Kevin75311/FingerLight/app/shots/shot_library.png

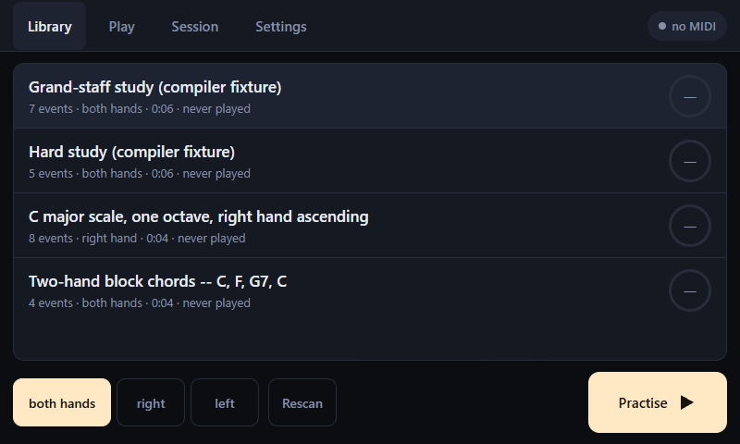
app/shots/shot_library.png
