Kevin75311/FingerLight/app/shots/shot_play.png

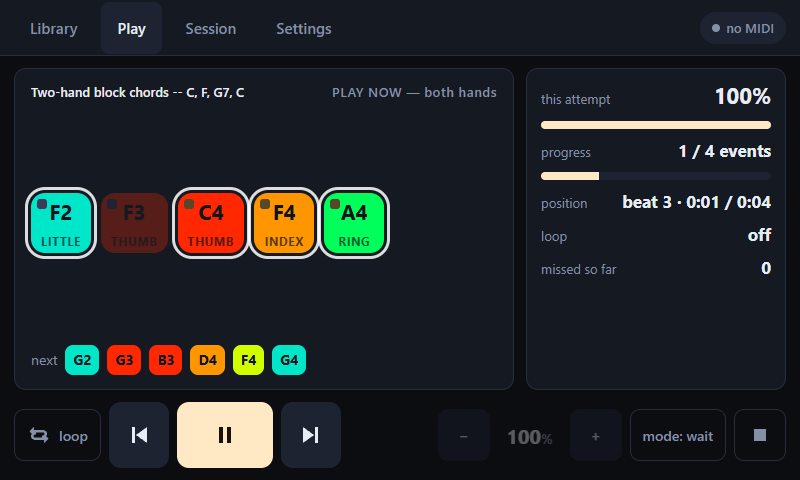
app/shots/shot_play.png
