Kevin75311/FingerLight/app/shots/shot_play_1280x720.png

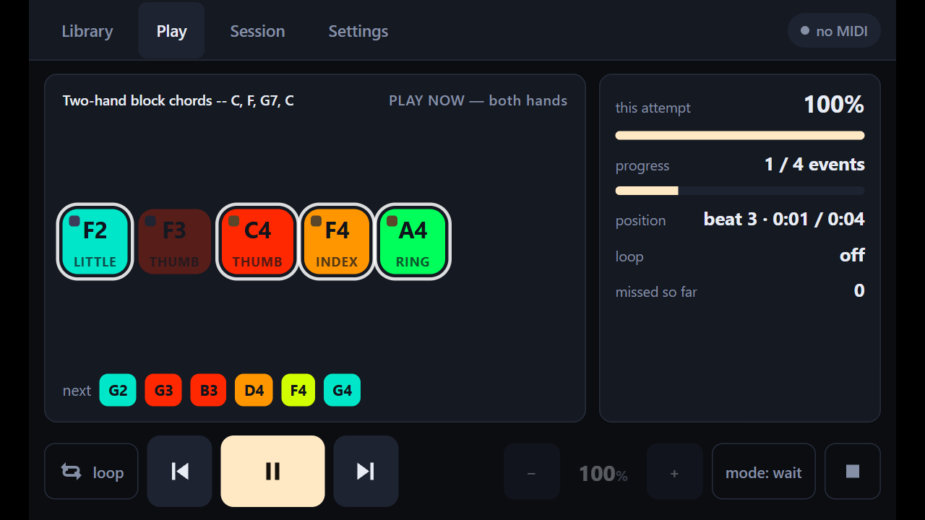
app/shots/shot_play_1280x720.png
