Kevin75311/FingerLight/app/shots/shot_play_along.png

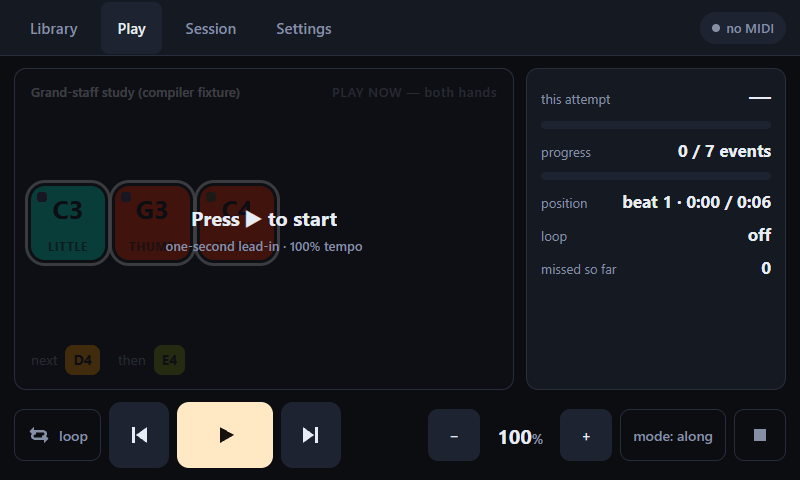
app/shots/shot_play_along.png
