Kevin75311/FingerLight/app/shots/shot_preview.png

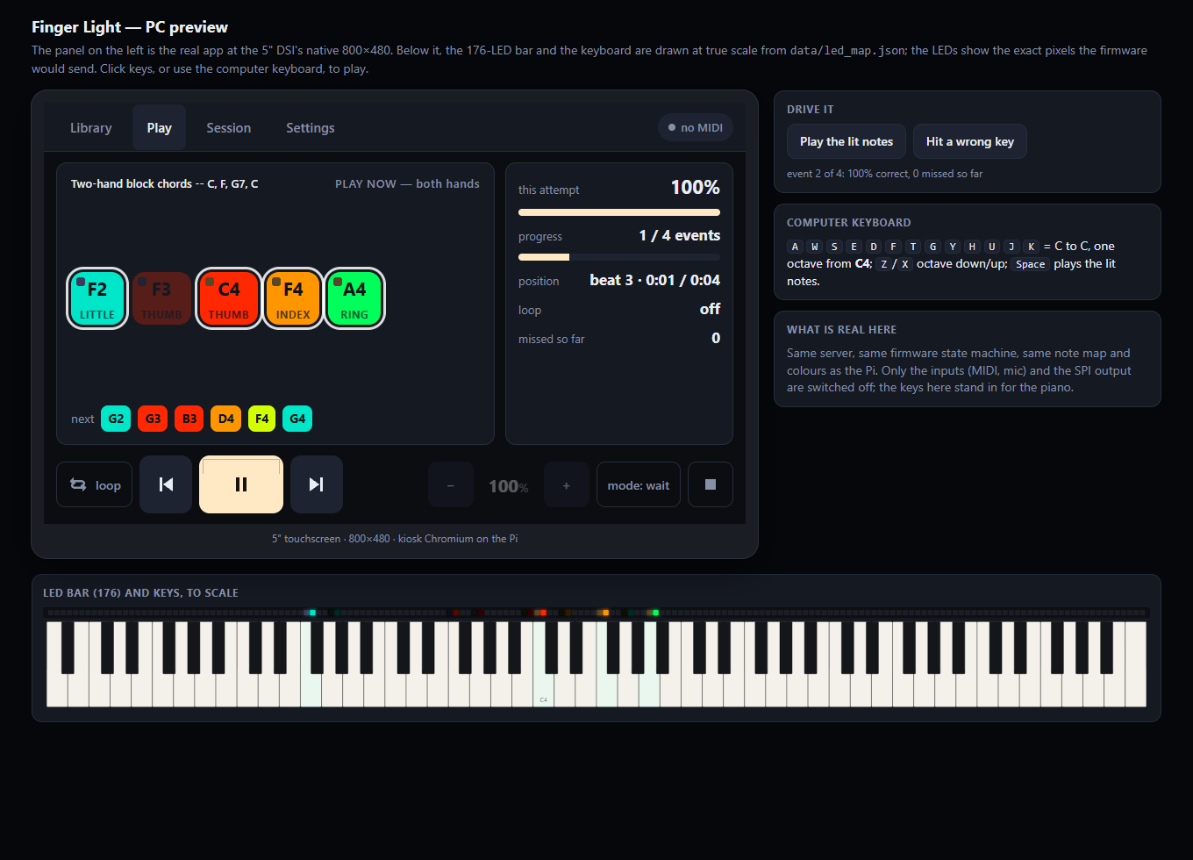
app/shots/shot_preview.png
