Kevin75311/FingerLight/app/shots/shot_session.png

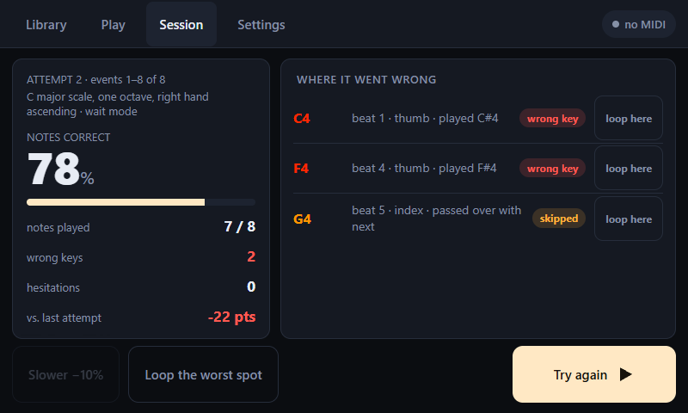
app/shots/shot_session.png
