Kevin75311/FingerLight/app/shots/shot_settings.png

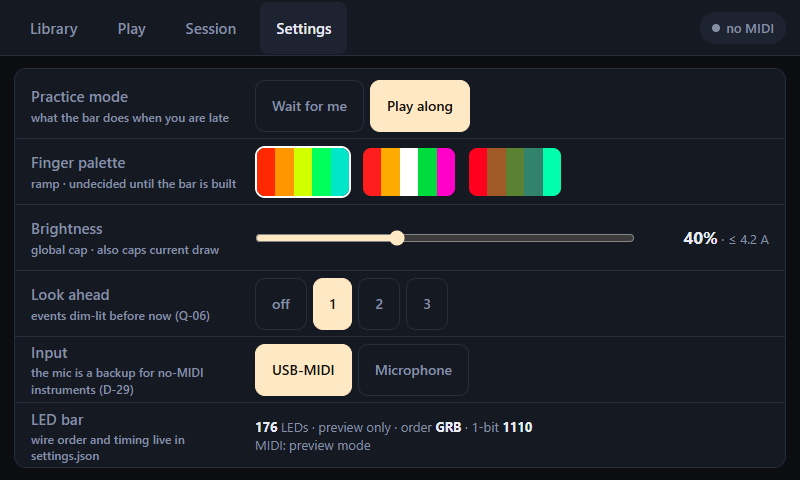
app/shots/shot_settings.png
