Kevin75311/FingerLight/hardware/cad/WS2812 144.step

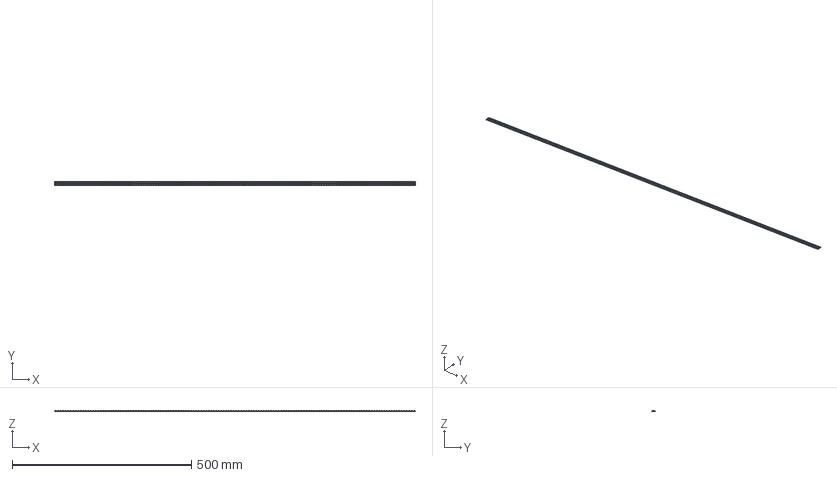
[picture p8: CAD file, 2026-10-29]
hardware/cad/WS2812 144.step
1008.0 x 11.9 x 2.10 mm
SMD x 144
WS2812 LED Chip x 144
PCB Strip x 144
Pads x 144
