Kevin75311/FingerLight/sim/assets/black_key_32.stl

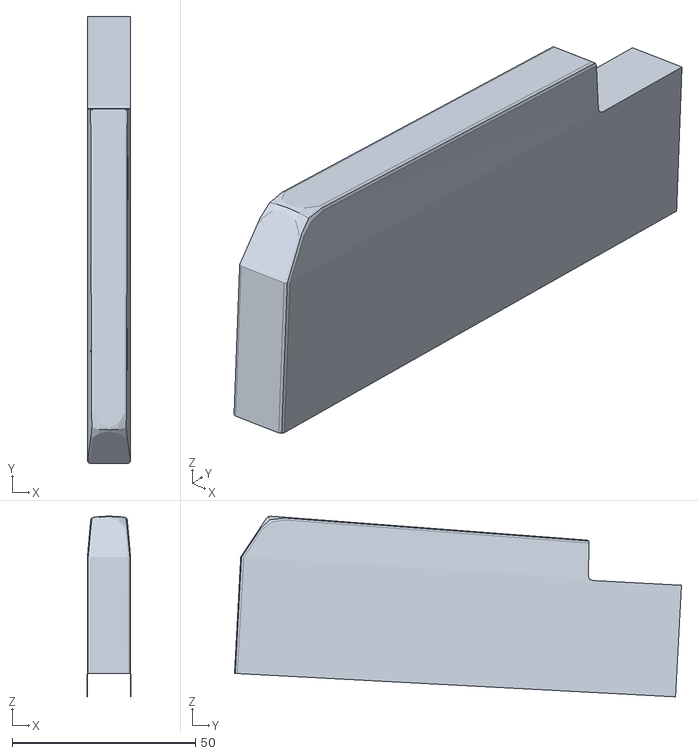
[picture p9: CAD file, 2026-10-29]
sim/assets/black_key_32.stl
11.8 x 122.0 x 49.3
