Kevin75311/FingerLight/sim/assets/led_chip.stl

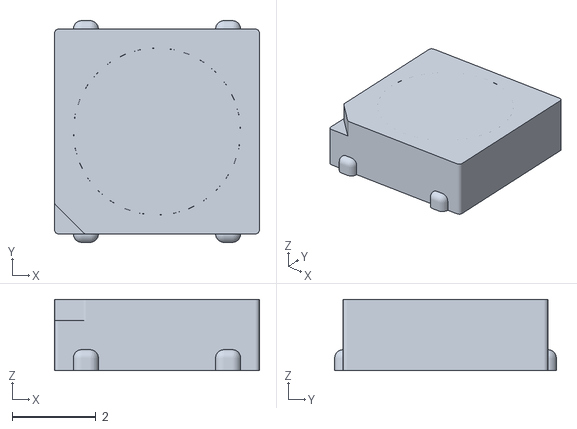
[picture p10: CAD file, 2026-10-29]
sim/assets/led_chip.stl
4.90 x 5.30 x 1.70
