Kevin75311/FingerLight/sim/assets/white_key_13.stl

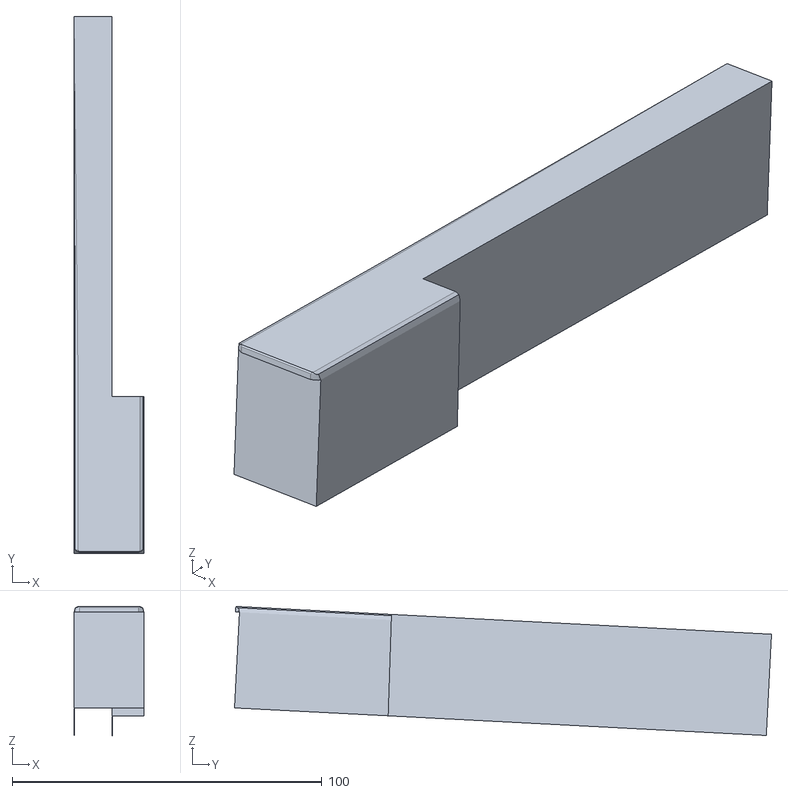
[picture p11: CAD file, 2026-10-29]
sim/assets/white_key_13.stl
22.6 x 173.5 x 41.7
