Kevin75311/FingerLight/sim/assets/white_key_01.stl

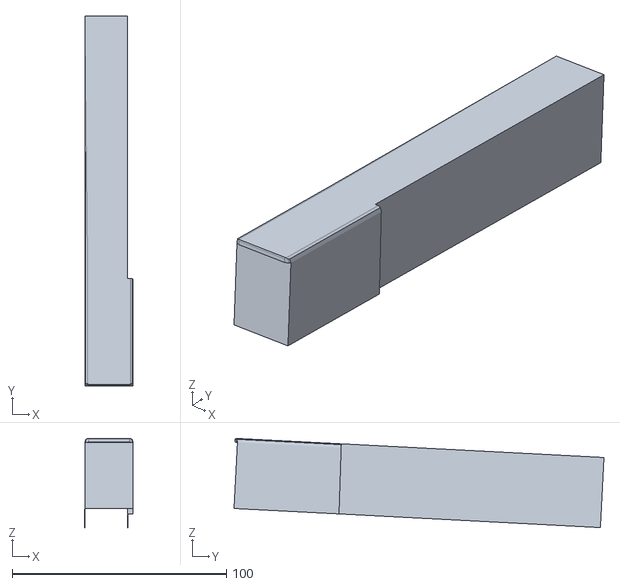
[picture p12: CAD file, 2026-10-29]
sim/assets/white_key_01.stl
22.6 x 172.9 x 41.7
