Kevin75311/FingerLight/sim/assets/cabinet.stl

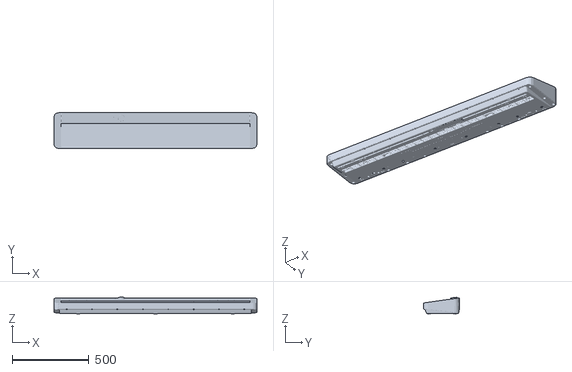
[picture p13: CAD file, 2026-10-29]
sim/assets/cabinet.stl
1322.0 x 232.2 x 108.7
