Kevin75311/FingerLight/sim/assets/strip_module.stl

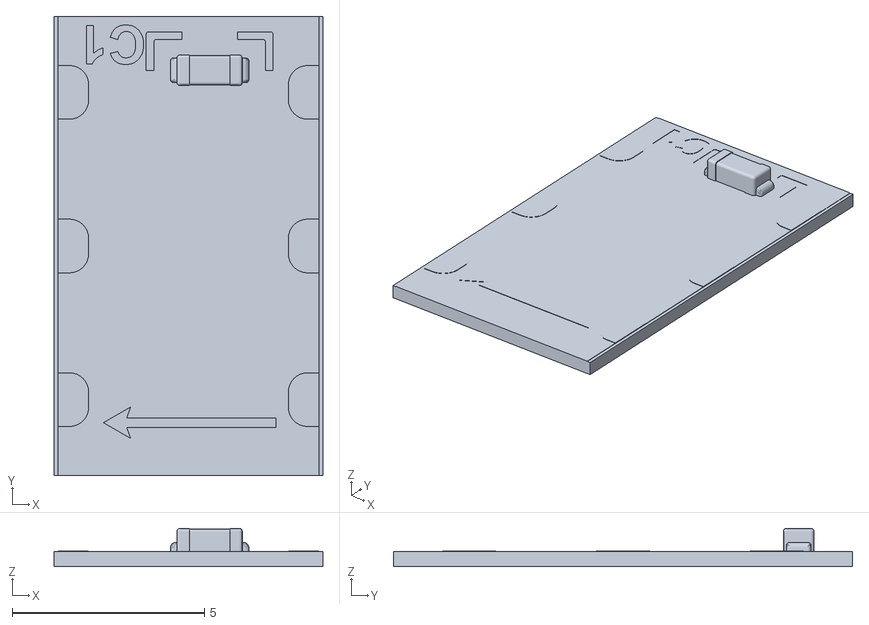
[picture p14: CAD file, 2026-10-29]
sim/assets/strip_module.stl
7.00 x 11.9 x 1.00
