Kevin75311/FingerLight/(list of files, cad)

Other CAD files:
sim/assets/black_key_04.stl
sim/assets/black_key_06.stl
sim/assets/white_key_11.stl
sim/assets/white_key_04.stl
sim/assets/white_key_17.stl
sim/assets/black_key_24.stl
sim/assets/white_key_28.stl
sim/assets/black_key_31.stl
sim/assets/black_key_09.stl
sim/assets/black_key_21.stl
sim/assets/white_key_39.stl
sim/assets/white_key_51.stl
sim/assets/white_key_20.stl
sim/assets/black_key_03.stl
sim/assets/white_key_48.stl
sim/assets/white_key_09.stl
sim/assets/white_key_34.stl
sim/assets/white_key_23.stl
sim/assets/white_key_35.stl
sim/assets/white_key_16.stl
sim/assets/black_key_35.stl
sim/assets/white_key_45.stl
sim/assets/black_key_07.stl
sim/assets/white_key_19.stl
sim/assets/black_key_28.stl
sim/assets/black_key_05.stl
sim/assets/black_key_15.stl
sim/assets/black_key_17.stl
sim/assets/white_key_18.stl
sim/assets/white_key_32.stl
sim/assets/white_key_42.stl
sim/assets/black_key_11.stl
sim/assets/black_key_01.stl
sim/assets/white_key_43.stl
sim/assets/white_key_50.stl
sim/assets/white_key_14.stl
sim/assets/black_key_13.stl
sim/assets/black_key_14.stl
sim/assets/white_key_24.stl
sim/assets/black_key_19.stl
sim/assets/white_key_12.stl
sim/assets/white_key_26.stl
sim/assets/white_key_47.stl
sim/assets/black_key_26.stl
sim/assets/white_key_36.stl
sim/assets/white_key_44.stl
sim/assets/white_key_15.stl
sim/assets/black_key_36.stl
sim/assets/white_key_52.stl
sim/assets/black_key_22.stl
sim/assets/black_key_33.stl
sim/assets/white_key_40.stl
sim/assets/white_key_46.stl
sim/assets/white_key_08.stl
sim/assets/black_key_12.stl
sim/assets/white_key_21.stl
sim/assets/white_key_37.stl
sim/assets/white_key_07.stl
sim/assets/white_key_02.stl
sim/assets/black_key_29.stl
sim/assets/white_key_49.stl
sim/assets/black_key_16.stl
sim/assets/white_key_33.stl
sim/assets/white_key_10.stl
sim/assets/white_key_29.stl
sim/assets/white_key_25.stl
sim/assets/white_key_30.stl
sim/assets/white_key_03.stl
sim/assets/black_key_02.stl
sim/assets/white_key_27.stl
sim/assets/white_key_22.stl
sim/assets/black_key_25.stl
sim/assets/white_key_41.stl
sim/assets/black_key_30.stl
sim/assets/black_key_10.stl
sim/assets/white_key_06.stl
sim/assets/black_key_08.stl
sim/assets/black_key_20.stl
sim/assets/black_key_34.stl
sim/assets/white_key_05.stl
sim/assets/white_key_38.stl
sim/assets/black_key_27.stl
sim/assets/white_key_31.stl
sim/assets/black_key_23.stl
sim/assets/black_key_18.stl
