Kevin75311/FingerLight/hardware/wiring/wiring.png

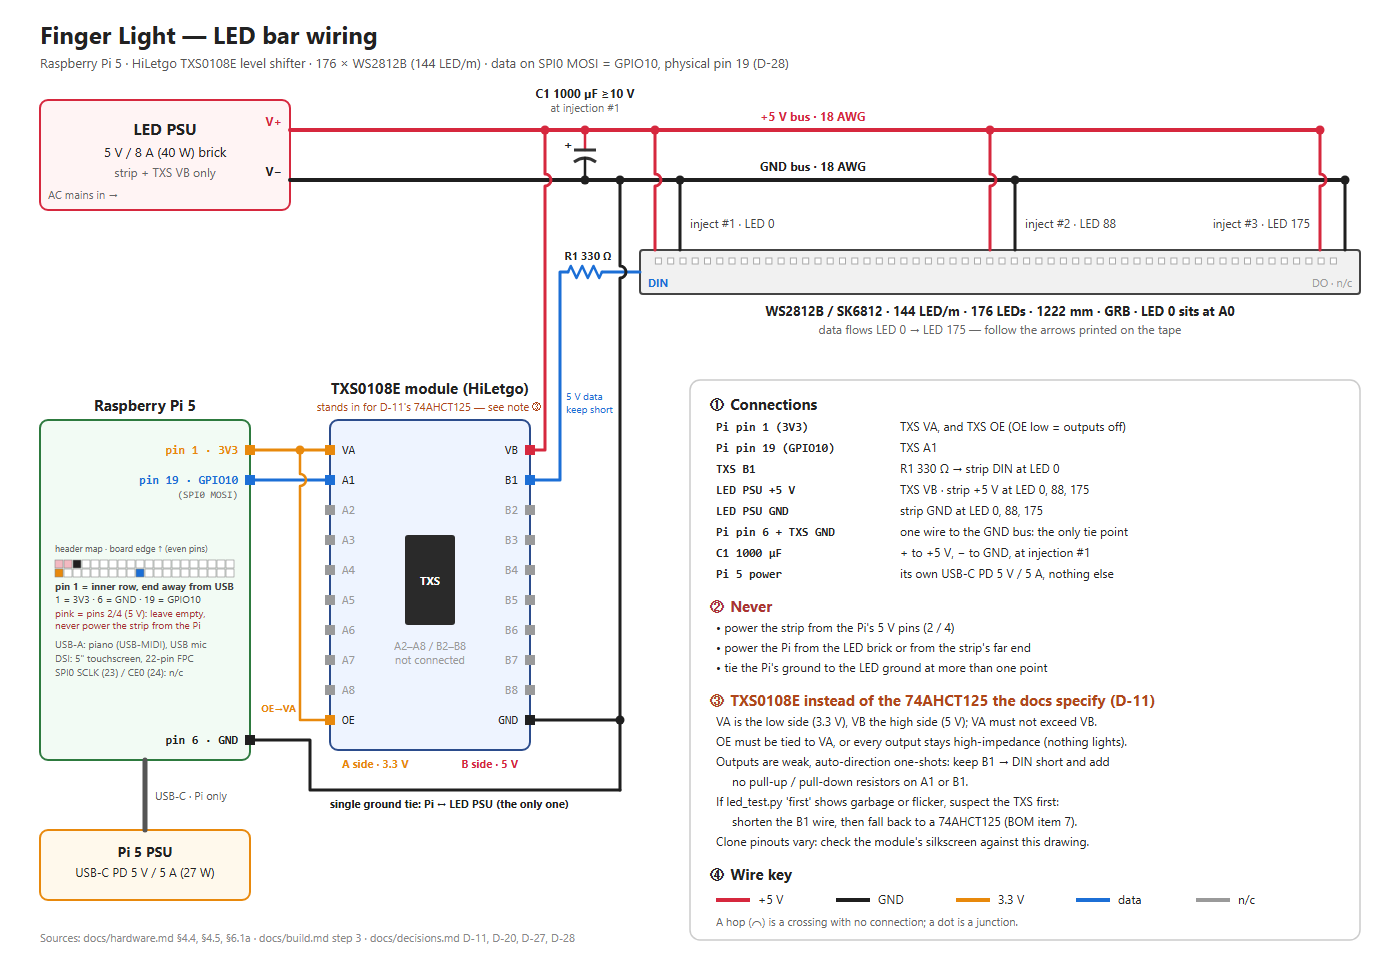
hardware/wiring/wiring.png
