Kevin75311/FingerLight/(commit log)

2026-10-29 chore: initial commit of FingerLight project
    App, firmware, score pipeline, simulation, docs and hardware notes.
    Ignores third-party clone (external/), the >100 MB vendor CAD file,
    generated sim renders, Python caches and local credential files.
    [WS2812 144.step, black_key_01.stl, black_key_02.stl, black_key_03.stl, black_key_04.stl, black_key_05.stl, black_key_06.stl, black_key_07.stl]
2026-10-29 Add smoke gate, free play and per-key LED calibration
    Objective 0 - tools/hw/smoke.py: one guided bring-up run (preflight, three
    strip patterns with yes/no checks, all 88 keys lit through the real map as
    they are played). Reports dead/stuck keys, velocity range, pedal, and
    Pi-side note->LED time; writes ~/.fingerlight/smoke-report.json.
    Objective 1 - free play: whenever no attempt is live the bar lights what is
    played. Solid / split / rainbow / velocity styles, swatches, split key,
    release fade, sustain-pedal hold (MidiDecoder(pedal=True) now surfaces CC 64
    as PedalEvent edges). New Free play tab; Shift is the pedal in /preview.
    Objective 2 - per-key calibration: Settings -> Calibrate keys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
    [engine.py, inputs.py, server.py, smoke.py]
2026-10-30 Add led_mirror: drive the bar with its data input at the C8 end
    The bar is mounted with the strip's data input at the right, so every key lit
    its mirror image. Strip(mirror=True) reverses only the wire order of pixels
    (i -> n-1-i); callers, the note map, calibration offsets and the preview keep
    indexing from A0. Upstream's `reverse` (n - pos) is one LED off and folds A0
    onto the clamp, so it is not used.
    The app reads it from settings.json (led_mirror); smoke.py and led_test.py take
    --mirror/--no-mirror and default to that saved setting.
    [engine.py, led_test.py, leds.py, server.py, smoke.py]
